BRimoldi/BMW-s-Wonder-Wheel-to-Bluetooth/README.md

# Wonder Wheel to Bluetooth Keystroke Converter

Control the Scenic navigation app via your BMW motorcycle’s Wonder Wheel.

## Project Overview

This project enables the use of a BMW motorcycle’s Multi-Function Controller, often called the Wonder Wheel (WW) to control the Scenic navigation app (running on an iPhone; an Android version has been announced). It works by implementing a LIN slave protocol that captures WW inputs and converts them into Bluetooth keystrokes, which are then interpreted by the app.

This implementation can also serve as a foundation for other projects that generate Bluetooth keystrokes in response to LIN bus messages.

A commercial version with similar functionality is the WunderLINQ X product by Black Box Embedded. (We started this project when WunderLINQ X was not yet on the market.)

## Safety & Liability

### ⚠️ Disclaimer

*   **This project is provided "as is"** with no guarantees of functionality or compatibility.
*   **I am not responsible** for accidents, injuries, or legal violations resulting from its use. Riding while distracted is dangerous. Always:
    *   Test features in a safe environment first.
    *   Prioritize road safety over interface interactions.
    *   Comply with local laws regarding device use while riding.

**By using this project, you assume all risks associated with its operation.**

## Hardware & Implementation

Core components:
*   Arduino Nano ESP32 (LIN + Bluetooth)
*   An NXP TJA1021 LIN transceiver
*   A diod
*   Three capacitors of roughly 220pF, 68nF, 47uF to 100uF
*   The 3-pin harness to the bike: BMW part 83 30 0 413 585

The electrical circuit is implemented on a compact 7cm × 3cm PCB.

### Provided files:
*   Arduino source code
*   Circuit schematics
*   3D-printable case design

## Installation

The device connects to the motorcycle via a 3-pin harness (for the M1000R located under the left-side tank cover), providing:
*   +12V
*   GND
*   LIN bus

Note: I am using the GND and +12V also to feed the Quad Lock Wireless Charging Head.

## Prerequisites

The motorcycle’s software must be navigation-ready. This is standard on models with a factory-installed navigator cradle, like the GS or the XR. For other models, a BMW dealer might have to make it navigation-ready via a software update.

A navigation-ready bike checks at regular intervals for a response from the dedicated LIN bus indicating that BMW’s Sat Nav is present. (This project’s LIN slave provides the same response.) If it is the case, a "TFT" message appears in the top-left corner of the TFT display. This tells the rider that the WW inputs control the TFT menu. (In the absence of a navigator, the WW always controls the TFT menu.)

## Operation

1.  **Switching to NAV Mode:** High-press and hold the Menu rocker-button (left handlebar) to switch to NAV mode. At this point the "TFT" message on the display is replaced by "NAV". In NAV mode, WW inputs are ignored by the TFT display and instead they are forwarded to the LIN bus dedicated to the navigator, allowing this project’s LIN slave to capture and convert them into Bluetooth keystrokes.
2.  **Input Mappings:**
    *   Left/Right WW pushes → Arrow keys (← / →)
    *   Up/Down WW rotations → Arrow keys (↑ / ↓)
    *   Long right WW push → ENTER
    *   Long left WW push → ESC
    *   (A low-press of the Menu button reverts to TFT mode.)

## Compatibility

Works with any app supporting Bluetooth keyboard inputs (arrows, ENTER, ESC).

## Credit

The LIN slave implementation is based on [LIN Slave Portable Arduino](https://github.com/gicking/LIN_slave_portable_Arduino)

The BLE keyboard implementation is based on [ESP32-BLE-Keyboard](https://github.com/T-vK/ESP32-BLE-Keyboard)

## Software Installation Instructions
* Install the [Arduino IDE](http://arduino.cc)
* Via IDE Board Manager install "Arduino ESP32 Boards" for Nano ESP32
* From the [project Github](https://github.com/BRimoldi/BMW-s-Wonder-Wheel-to-Bluetooth) do the following:
    *    Download the folders LIN_slave_portable_Arduino and ESP32-BLE-Keyboard and place them inside `~/Arduino/libraries`
    *    Download the project folder WWToPhoneInterface (and place it anywhere)
* Compile WWToPhoneInterface.ino for Arduino Nano ESP32

## Demo Video
https://www.youtube.com/watch?v=-cVcGIMZuJ0

## Feedback
Send feedback to WWtoBluetooth@icloud.com
