BRimoldi/BMW-s-Wonder-Wheel-to-Bluetooth/Hardware/someClarifications.rtf

Here are some clarifications for the electronic components in this project:

1. Electrolytic Capacitors (47µF to 100µF): The exact capacitance value is not critical; you can use any capacitor rated between 47µF and 100µF. It must be rated for 15V DC or higher.
⚠️ Polarity Matters: These capacitors have a positive (+) and negative (-) lead. The stripe on the side typically marks the negative lead. Connect as shown in the schematic.

2. Diode: since currents and voltages are very small, you can use a standard silicone diode (e.g. 1N400x that withstands at least 15V DC). Direction is critical.

3. The other (smaller, typically ceramic) capacitors are non-polarized, so you can insert them in any direction. Their job is to filter high-frequency electrical noise. Just make sure that they resist 15V DC.
