BRimoldi/BMW-s-Wonder-Wheel-to-Bluetooth/Hardware/prototypePhoto.pdf

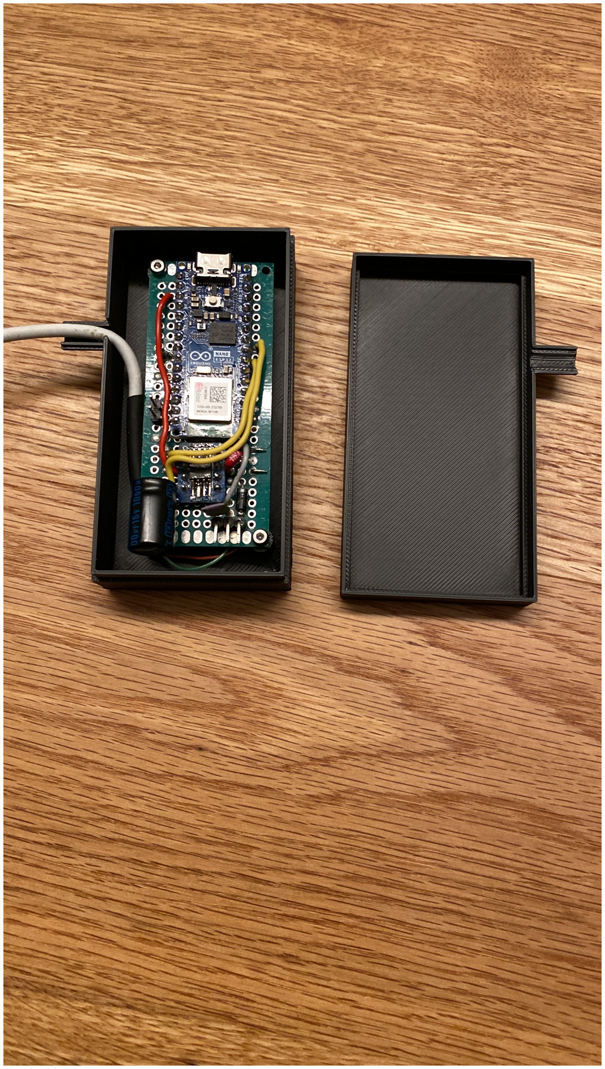
[picture p1: page 1]
