BRimoldi/BMW-s-Wonder-Wheel-to-Bluetooth/Hardware/Arduino Box v2.stl

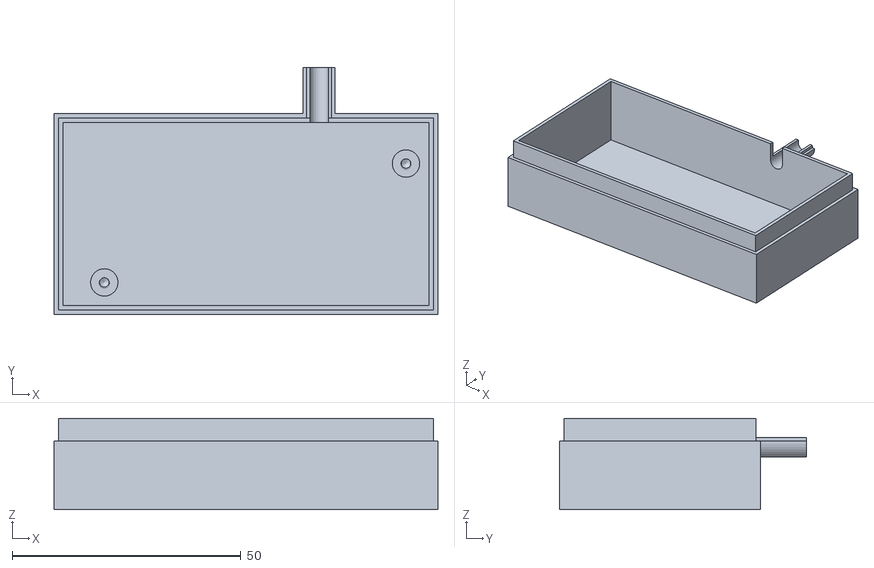
[picture p2: CAD file, 2025-09-21]
Hardware/Arduino Box v2.stl
84.0 x 54.0 x 20.0
