BRimoldi/BMW-s-Wonder-Wheel-to-Bluetooth/Hardware/ElectricalSchematic.pdf

1 | 8
2 | 7

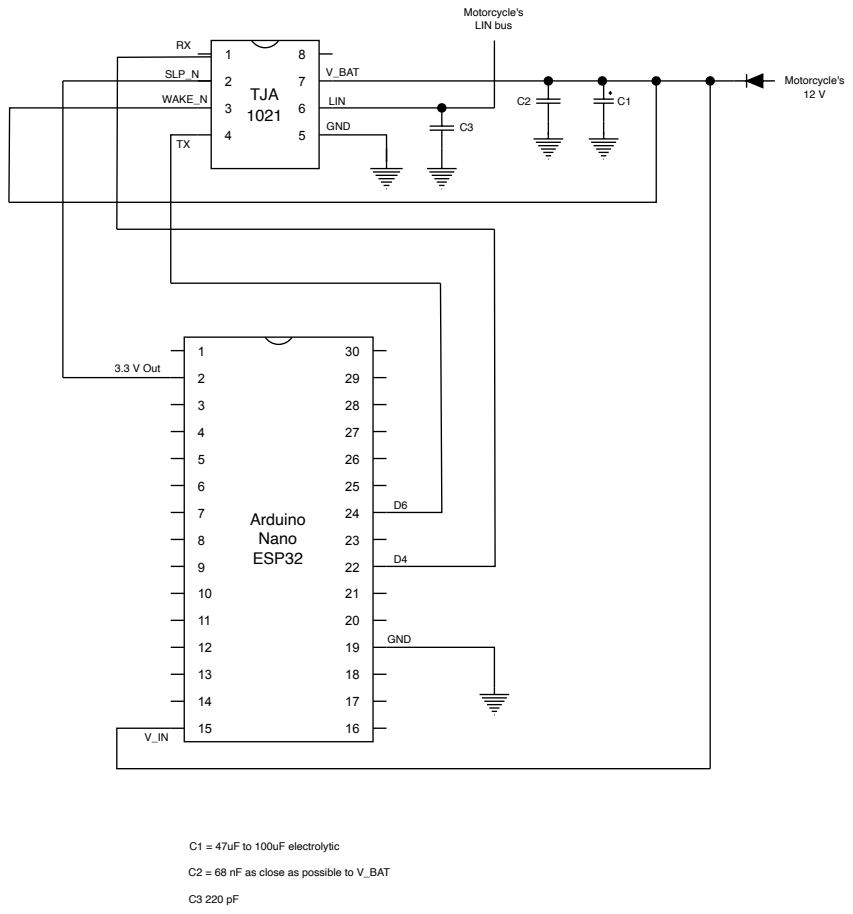
[picture p3: page 1]
Arduino Nano ESP32; TJA 1021; WAKE_N; 3.3 V Out; V_BAT; Motorcycle's; SLP_N; LIN; GND; Motorcycle's LIN bus; C1 = 47uF to 100uF electrolytic

C2 = 68 nF as close as possible to V_BAT
