BRimoldi/BMW-s-Wonder-Wheel-to-Bluetooth/(commit log)

2025-09-11 Update README.md
    added the link to Georg Icking-Konert’s work
2025-09-21 Delete case directory
    Repository restructured
2025-10-13 Add files via upload
    Added the note about using the harness to feed the Quad Lock charging head.
